aftekeli/CSE328-Term-Project/videos/README.md

# Project Demonstration Video

This folder contains the live demonstration video for the CSE328 Motor Vibration Monitoring project.

Video file: [project_demo.mp4](project_demo.mp4)

External streaming link: [Watch the demo video on SharePoint][sharepoint-demo-video]

The video shows the physical ESP32 prototype, sensor readings, OLED output, relay-controlled motor behavior, and Arduino IoT Cloud dashboard evidence.

[sharepoint-demo-video]: https://akdeniz-my.sharepoint.com/:v:/g/personal/20220808617_ogr_akdeniz_edu_tr/IQCHF4eCXK6uSpyXAuW32T1iAUYRYIJSyH79AQonBrvTuKU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
