aftekeli/CSE328-Term-Project/images/hardware_setup.jpg

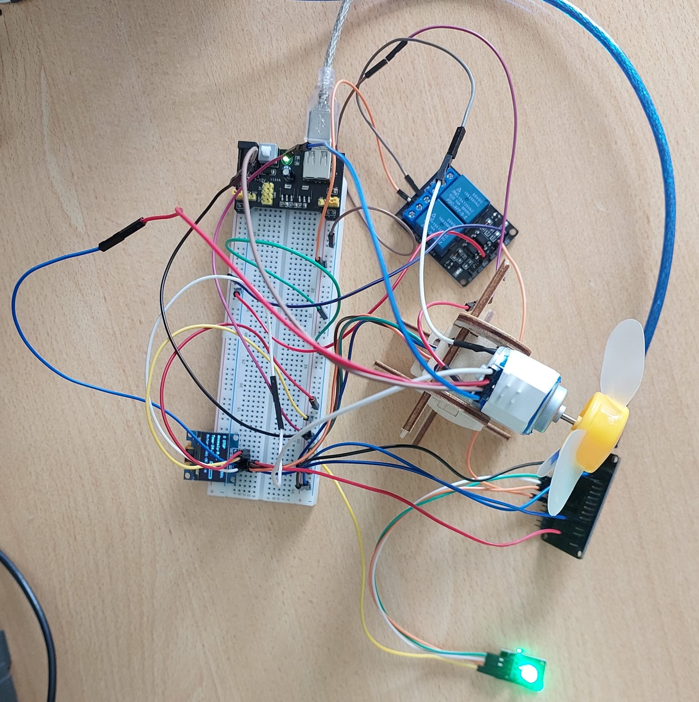
images/hardware_setup.jpg
