aftekeli/CSE328-Term-Project/(commit log)

2026-04-10 Initial commit: ESP32 Motor Fault Detection with TinyML
2026-05-03 Add training data and Edge Impulse model library
    [NORMAL.001.csv, NORMAL.002.csv, NORMAL.003.csv, NORMAL.004.csv, NORMAL.005.csv, NORMAL.006.csv, NORMAL.007.csv, NORMAL.008.csv]
2026-05-03 Remove local Arduino secrets file
2026-05-03 Fix README wiring details and clean up repo
